hulakov/NosVolt/hardware/NosVolt.kicad_pcb

## KiCad design hardware/NosVolt.kicad_pcb (2026-01-12)

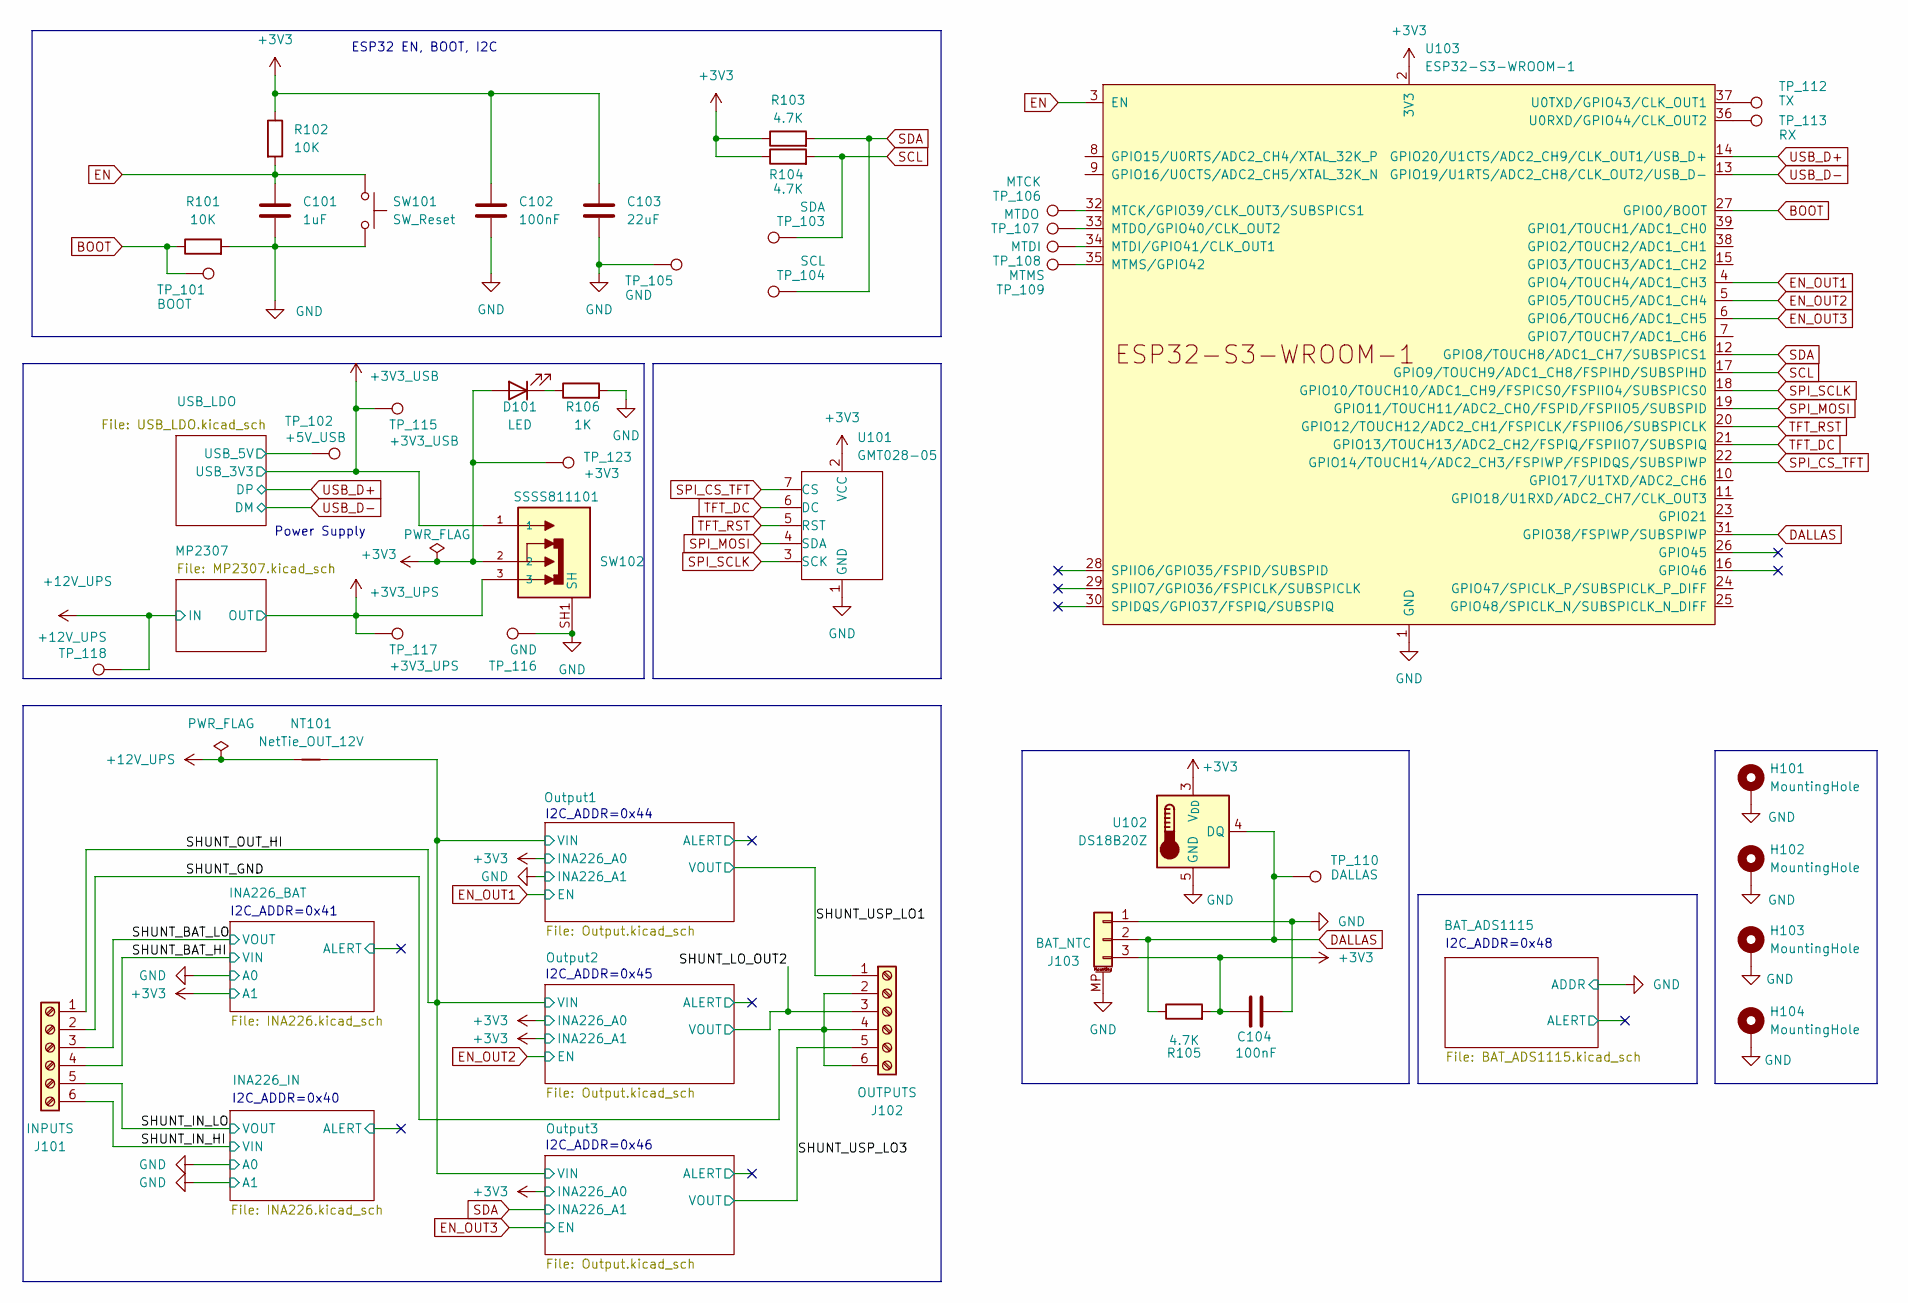
[picture p1: schematic NosVolt.kicad_sch]

Parts:
C101: 1uF; C_0805_2012Metric_Pad1.18x1.45mm_HandSolder
C102, C104: 100nF; C_0603_1608Metric_Pad1.08x0.95mm_HandSolder
C103: 22uF; C_0805_2012Metric_Pad1.18x1.45mm_HandSolder
D101: LED; LED_0805_2012Metric_Pad1.15x1.40mm_HandSolder
H101, H102, H103, H104: MountingHole; MountingHole_3.2mm_M3_Pad_Via
J101: INPUTS; TerminalBlock_Phoenix_MKDS-1,5-6-5.08_1x06_P5.08mm_Horizont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
J102: OUTPUTS; TerminalBlock_Phoenix_MKDS-1,5-6-5.08_1x06_P5.08mm_Horizont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
J103: BAT_NTC; JST_GH_SM03B-GHS-TB_1x03-1MP_P1.25mm_Horizontal
NT101: NetTie_OUT_12V; NetTie-2_SMD_Pad0.5mm
R101, R102: 10K; R_0603_1608Metric_Pad0.98x0.95mm_HandSolder
R103, R104, R105: 4.7K; R_0603_1608Metric_Pad0.98x0.95mm_HandSolder
R106: 1K; R_0603_1608Metric_Pad0.98x0.95mm_HandSolder
SW101: SW_Reset; SW_Push_SPST_NO_Alps_SKRK
SW102: SSSS811101; SW_SSSS811101
TP_101: BOOT; TestPoint_Pad_1.0x1.0mm
TP_102: +5V_USB; TestPoint_Pad_1.0x1.0mm
TP_103: SDA; TestPoint_Pad_1.0x1.0mm
TP_104: SCL; TestPoint_Pad_1.0x1.0mm
TP_105, TP_116: GND; TestPoint_Pad_1.0x1.0mm
TP_106: MTCK; TestPoint_Pad_1.0x1.0mm
TP_107: MTDO; TestPoint_Pad_1.0x1.0mm
TP_108: MTDI; TestPoint_Pad_1.0x1.0mm
TP_109: MTMS; TestPoint_Pad_1.0x1.0mm
TP_110: DALLAS; TestPoint_Pad_1.0x1.0mm
TP_112: TX; TestPoint_Pad_1.0x1.0mm
TP_113: RX; TestPoint_Pad_1.0x1.0mm
TP_115: +3V3_USB; TestPoint_Pad_1.0x1.0mm
TP_117: +3V3_UPS; TestPoint_Pad_1.0x1.0mm
TP_118: +12V_UPS; TestPoint_Pad_1.0x1.0mm
TP_123: +3V3; TestPoint_Pad_1.0x1.0mm
U101: GMT028-05
U102: DS18B20Z; SOIC-8_3.9x4.9mm_P1.27mm
U103: ESP32-S3-WROOM-1

Connections:
+3V3: C102.1, C103.1, C104.1, D101.2 (A), J103.3, R102.1, R103.1, R104.1, R105.2, SW102.2, TP_123.1, U101.2 (VCC), U102.3 (V_{DD}), U103.2 (3V3); also elsewhere on the board
+3V3_UPS: SW102.3, TP_117.1; also elsewhere on the board
+3V3_USB: SW102.1, TP_115.1; also elsewhere on the board
+12V_UPS: NT101.1, TP_118.1; also elsewhere on the board
/SHUNT_BAT_HI: J101.4; also elsewhere on the board
/SHUNT_BAT_LO: J101.3; also elsewhere on the board
/SHUNT_GND: J101.2, J102.2, J102.4, J102.6
/SHUNT_IN_HI: J101.6; also elsewhere on the board
/SHUNT_IN_LO: J101.5; also elsewhere on the board
/SHUNT_LO_OUT2: J102.3; also elsewhere on the board
/SHUNT_OUT_HI: J101.1, NT101.2; also elsewhere on the board
/SHUNT_USP_LO1: J102.1; also elsewhere on the board
/SHUNT_USP_LO3: J102.5; also elsewhere on the board
/USB_LDO/USB_5V: TP_102.1; also elsewhere on the board
BOOT: R101.1, TP_101.1, U103.27 (GPIO0/BOOT)
DALLAS: J103.2, R105.1, TP_110.1, U102.4 (DQ), U103.31 (GPIO38/FSPIWP/SUBSPIWP)
EN: C101.1, R102.2, SW101.1, U103.3 (EN)
EN_OUT1: U103.4 (GPIO4/TOUCH4/ADC1_CH3); also elsewhere on the board
EN_OUT2: U103.5 (GPIO5/TOUCH5/ADC1_CH4); also elsewhere on the board
EN_OUT3: U103.6 (GPIO6/TOUCH6/ADC1_CH5); also elsewhere on the board
GND: C101.2, C102.2, C103.2, C104.2, H101.1, H102.1, H103.1, H104.1, J103.1, J103.MP (MountPin), R101.2, R106.2, SW101.2, SW102.SH1 (SH), SW102.SH2 (SH), SW102.SH3 (SH), SW102.SH4 (SH), TP_105.1, TP_116.1, U101.1 (GND), U102.5 (GND), U103.1 (GND), U103.40 (GND), U103.41 (GND); also elsewhere on the board
unnamed: D101.1 (K), R106.1
unnamed: TP_106.1, U103.32 (MTCK/GPIO39/CLK_OUT3/SUBSPICS1)
unnamed: TP_108.1, U103.34 (MTDI/GPIO41/CLK_OUT1)
unnamed: TP_107.1, U103.33 (MTDO/GPIO40/CLK_OUT2)
unnamed: TP_109.1, U103.35 (MTMS/GPIO42)
unnamed: TP_113.1, U103.36 (U0RXD/GPIO44/CLK_OUT2)
unnamed: TP_112.1, U103.37 (U0TXD/GPIO43/CLK_OUT1)
SCL: R104.2, TP_103.1, U103.17 (GPIO9/TOUCH9/ADC1_CH8/FSPIHD/SUBSPIHD); also elsewhere on the board
SDA: R103.2, TP_104.1, U103.12 (GPIO8/TOUCH8/ADC1_CH7/SUBSPICS1); also elsewhere on the board
SPI_CS_TFT: U101.7 (CS), U103.22 (GPIO14/TOUCH14/ADC2_CH3/FSPIWP/FSPIDQS/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)
SPI_MOSI: U101.4 (SDA), U103.19 (GPIO11/TOUCH11/ADC2_CH0/FSPID/FSPIIO5/S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)
SPI_SCLK: U101.3 (SCK), U103.18 (GPIO10/TOUCH10/ADC1_CH9/FSPICS0/FSPIIO4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)
TFT_DC: U101.6 (DC), U103.21 (GPIO13/TOUCH13/ADC2_CH2/FSPIQ/FSPIIO7/S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)
TFT_RST: U101.5 (RST), U103.20 (GPIO12/TOUCH12/ADC2_CH1/FSPICLK/FSPIIO6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)
USB_D+: U103.14 (GPIO20/U1CTS/ADC2_CH9/CLK_OUT1/USB_D+); also elsewhere on the board
USB_D-: U103.13 (GPIO19/U1RTS/ADC2_CH8/CLK_OUT2/USB_D-); also elsewhere on the board

Notes on the sheet:
Power Supply
I2C_ADDR=0x46
I2C_ADDR=0x41
ESP32 EN, BOOT, I2C
I2C_ADDR=0x48
I2C_ADDR=0x45
I2C_ADDR=0x40
I2C_ADDR=0x44

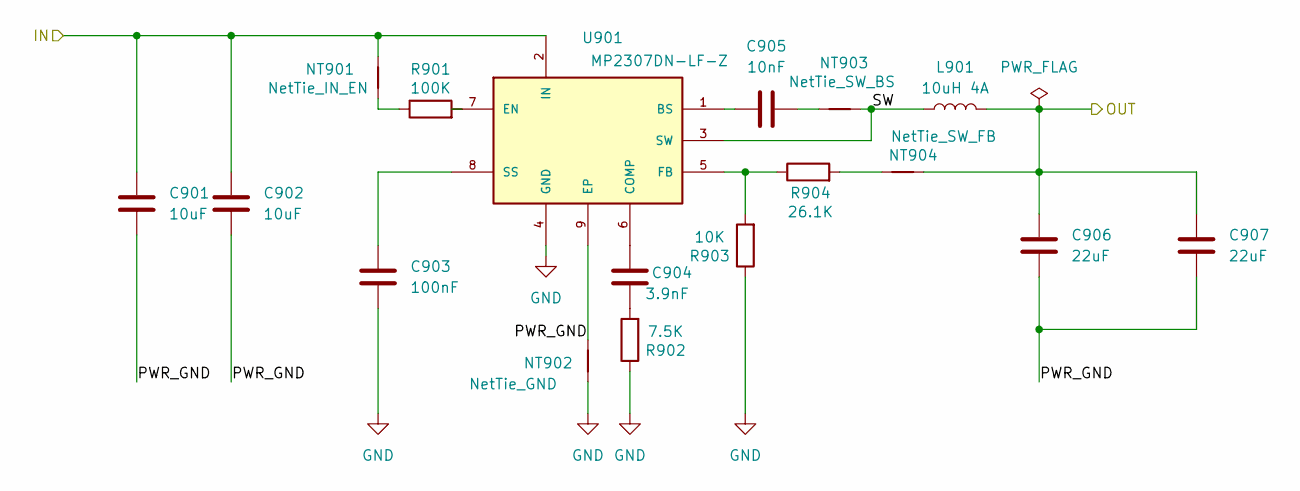
[picture p2: schematic MP2307.kicad_sch]

Parts:
C901, C902: 10uF; C_0805_2012Metric_Pad1.18x1.45mm_HandSolder
C903: 100nF; C_0603_1608Metric_Pad1.08x0.95mm_HandSolder
C904: 3.9nF; C_0805_2012Metric_Pad1.18x1.45mm_HandSolder
C905: 10nF; C_0603_1608Metric_Pad1.08x0.95mm_HandSolder
C906, C907: 22uF; C_0805_2012Metric_Pad1.18x1.45mm_HandSolder
L901: 10uH 4A; L_6.3x6.3_H3
NT901: NetTie_IN_EN; NetTie-2_SMD_Pad0.5mm
NT902: NetTie_GND; NetTie-2_SMD_Pad0.5mm
NT903: NetTie_SW_BS; NetTie-2_SMD_Pad0.5mm
NT904: NetTie_SW_FB; NetTie-2_SMD_Pad0.5mm
R901: 100K; R_0603_1608Metric_Pad0.98x0.95mm_HandSolder
R902: 7.5K; R_0603_1608Metric_Pad0.98x0.95mm_HandSolder
R903: 10K; R_0603_1608Metric_Pad0.98x0.95mm_HandSolder
R904: 26.1K; R_0603_1608Metric_Pad0.98x0.95mm_HandSolder
U901: MP2307DN-LF-Z; SOIC-8-1EP_3.9x4.9mm_P1.27mm_EP2.29x3mm_ThermalVias

Connections:
+3V3_UPS: C906.1, C907.1, L901.2, NT904.2; also elsewhere on the board
+12V_UPS: C901.1, C902.1, NT901.1, U901.2 (IN); also elsewhere on the board
/MP2307/PWR_GND: C901.2, C902.2, C906.2, C907.2, NT902.2, U901.9 (EP)
/MP2307/SW: L901.1, NT903.2, U901.3 (SW)
GND: C903.2, NT902.1, R902.1, R903.1, U901.4 (GND); also elsewhere on the board
unnamed: C904.2, R902.2
unnamed: C905.2, NT903.1
unnamed: NT901.2, R901.1
unnamed: NT904.1, R904.2
unnamed: C905.1, U901.1 (BS)
unnamed: C904.1, U901.6 (COMP)
unnamed: R901.2, U901.7 (EN)
unnamed: R903.2, R904.1, U901.5 (FB)
unnamed: C903.1, U901.8 (SS)

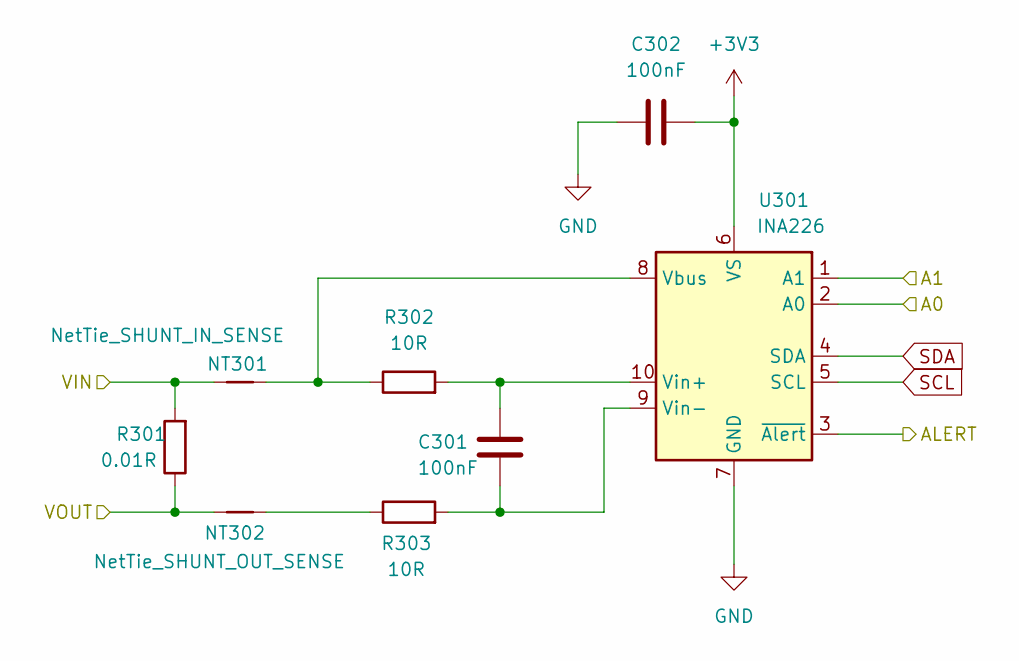
[picture p3: schematic INA226.kicad_sch]

Parts:
C301, C302: 100nF; C_0603_1608Metric_Pad1.08x0.95mm_HandSolder
NT301: NetTie_SHUNT_IN_SENSE; NetTie-2_SMD_Pad0.5mm
NT302: NetTie_SHUNT_OUT_SENSE; NetTie-2_SMD_Pad0.5mm
R301: 0.01R; R_2512_6332Metric_Pad1.40x3.35mm_HandSolder
R302, R303: 10R; R_0603_1608Metric_Pad0.98x0.95mm_HandSolder
U301: INA226; VSSOP-10_3x3mm_P0.5mm

Connections:
+3V3: C302.1, U301.6 (VS); also elsewhere on the board
/INA226_IN/ALERT: U301.3 (~Alert)
/SHUNT_IN_HI: NT301.1, R301.2; also elsewhere on the board
/SHUNT_IN_LO: NT302.1, R301.1; also elsewhere on the board
GND: C302.2, U301.1 (A1), U301.2 (A0), U301.7 (GND); also elsewhere on the board
unnamed: NT302.2, R303.1
unnamed: NT301.2, R302.1, U301.8 (Vbus)
unnamed: C301.1, R302.2, U301.10 (Vin+)
unnamed: C301.2, R303.2, U301.9 (Vin-)
SCL: U301.5 (SCL); also elsewhere on the board
SDA: U301.4 (SDA); also elsewhere on the board

Parts of its further copies:
C401, C402, C502, C504, C602, C604, C702, C704: 100nF; C_0603_1608Metric_Pad1.08x0.95mm_HandSolder
NT401, NT502, NT602, NT702: NetTie_SHUNT_IN_SENSE; NetTie-2_SMD_Pad0.5mm
NT402, NT503, NT603, NT703: NetTie_SHUNT_OUT_SENSE; NetTie-2_SMD_Pad0.5mm
R401, R504, R604, R704: 0.01R; R_2512_6332Metric_Pad1.40x3.35mm_HandSolder
R402, R403, R506, R507, R606, R607, R706, R707: 10R; R_0603_1608Metric_Pad0.98x0.95mm_HandSolder
U401, U501, U601, U701: INA226; VSSOP-10_3x3mm_P0.5mm

Connections of its further copies:
+3V3: C402.1, C504.1, C604.1, C704.1, U401.1 (A1), U401.6 (VS), U501.2 (A0), U501.6 (VS), U601.1 (A1), U601.2 (A0), U601.6 (VS), U701.2 (A0), U701.6 (VS); also elsewhere on the board
/INA226_BAT/ALERT: U401.3 (~Alert)
/Output1/ALERT: U701.3 (~Alert)
/Output1/SHUNT_DRAIN: NT702.1, R704.2; also elsewhere on the board
/Output2/ALERT: U601.3 (~Alert)
/Output2/SHUNT_DRAIN: NT602.1, R604.2; also elsewhere on the board
/Output3/ALERT: U501.3 (~Alert)
/Output3/SHUNT_DRAIN: NT502.1, R504.2; also elsewhere on the board
/SHUNT_BAT_HI: NT401.1, R401.2; also elsewhere on the board
/SHUNT_BAT_LO: NT402.1, R401.1; also elsewhere on the board
/SHUNT_LO_OUT2: NT603.1, R604.1; also elsewhere on the board
/SHUNT_USP_LO1: NT703.1, R704.1; also elsewhere on the board
/SHUNT_USP_LO3: NT503.1, R504.1; also elsewhere on the board
GND: C402.2, C504.2, C604.2, C704.2, U401.2 (A0), U401.7 (GND), U501.7 (GND), U601.7 (GND), U701.1 (A1), U701.7 (GND); also elsewhere on the board
unnamed: NT402.2, R403.1
unnamed: NT503.2, R507.1
unnamed: NT603.2, R607.1
unnamed: NT703.2, R707.1
unnamed: NT401.2, R402.1, U401.8 (Vbus)
unnamed: C401.1, R402.2, U401.10 (Vin+)
unnamed: C401.2, R403.2, U401.9 (Vin-)
unnamed: NT502.2, R506.1, U501.8 (Vbus)
unnamed: C502.1, R506.2, U501.10 (Vin+)
unnamed: C502.2, R507.2, U501.9 (Vin-)
unnamed: NT602.2, R606.1, U601.8 (Vbus)
unnamed: C602.1, R606.2, U601.10 (Vin+)
unnamed: C602.2, R607.2, U601.9 (Vin-)
unnamed: NT702.2, R706.1, U701.8 (Vbus)
unnamed: C702.1, R706.2, U701.10 (Vin+)
unnamed: C702.2, R707.2, U701.9 (Vin-)
SCL: U401.5 (SCL), U501.5 (SCL), U601.5 (SCL), U701.5 (SCL); also elsewhere on the board
SDA: U401.4 (SDA), U501.1 (A1), U501.4 (SDA), U601.4 (SDA), U701.4 (SDA); also elsewhere on the board

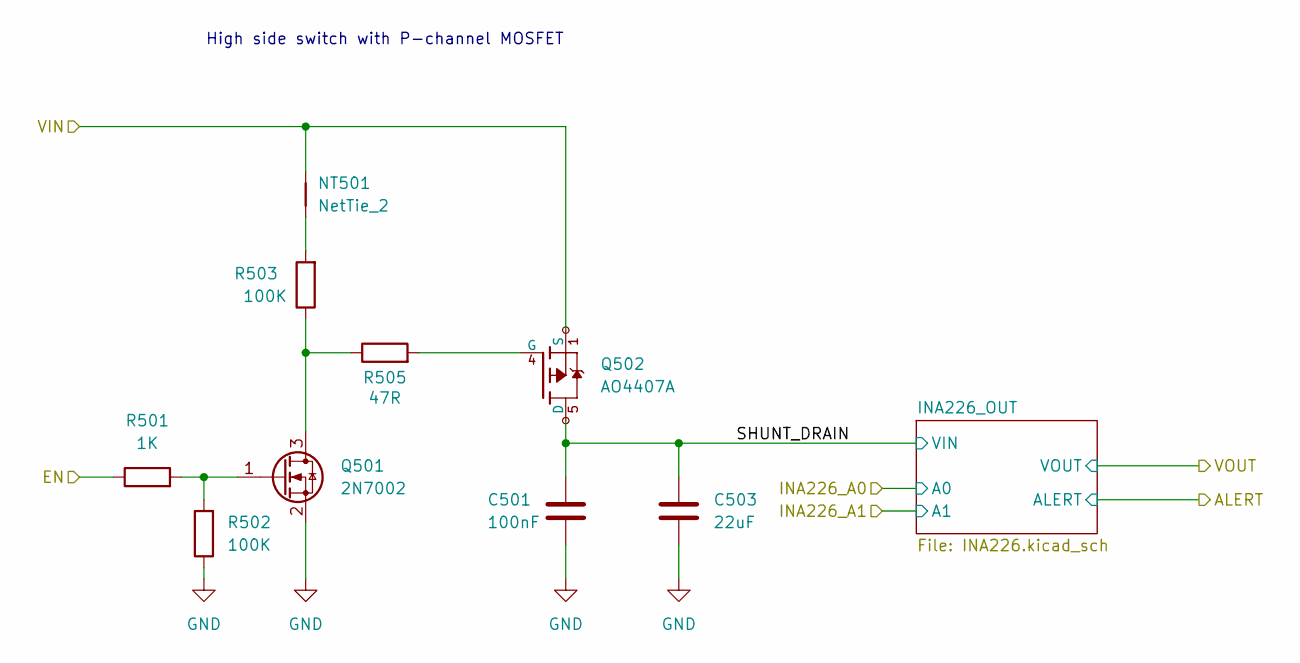
[picture p4: schematic Output.kicad_sch]

Parts:
C501: 100nF; C_0603_1608Metric_Pad1.08x0.95mm_HandSolder
C503: 22uF; C_0805_2012Metric_Pad1.18x1.45mm_HandSolder
NT501: NetTie_2; NetTie-2_SMD_Pad0.5mm
Q501: 2N7002; SOT-23
Q502: AO4407A; SOIC-8_3.9x4.9mm_P1.27mm
R501: 1K; R_0603_1608Metric_Pad0.98x0.95mm_HandSolder
R502, R503: 100K; R_0603_1608Metric_Pad0.98x0.95mm_HandSolder
R505: 47R; R_0603_1608Metric_Pad0.98x0.95mm_HandSolder

Connections:
/Output3/SHUNT_DRAIN: C501.1, C503.1, Q502.5 (D), Q502.6 (D), Q502.7 (D), Q502.8 (D); also elsewhere on the board
/SHUNT_OUT_HI: NT501.2, Q502.1 (S), Q502.2 (S), Q502.3 (S); also elsewhere on the board
EN_OUT3: R501.1; also elsewhere on the board
GND: C501.2, C503.2, Q501.2 (S), R502.1; also elsewhere on the board
unnamed: NT501.1, R503.2
unnamed: Q501.3 (D), R503.1, R505.1
unnamed: Q501.1 (G), R501.2, R502.2
unnamed: Q502.4 (G), R505.2

Parts of its further copies:
C601, C701: 100nF; C_0603_1608Metric_Pad1.08x0.95mm_HandSolder
C603, C703: 22uF; C_0805_2012Metric_Pad1.18x1.45mm_HandSolder
NT601, NT701: NetTie_2; NetTie-2_SMD_Pad0.5mm
Q601, Q701: 2N7002; SOT-23
Q602, Q702: AO4407A; SOIC-8_3.9x4.9mm_P1.27mm
R601, R701: 1K; R_0603_1608Metric_Pad0.98x0.95mm_HandSolder
R602, R603, R702, R703: 100K; R_0603_1608Metric_Pad0.98x0.95mm_HandSolder
R605, R705: 47R; R_0603_1608Metric_Pad0.98x0.95mm_HandSolder

Connections of its further copies:
/Output1/SHUNT_DRAIN: C701.1, C703.1, Q702.5 (D), Q702.6 (D), Q702.7 (D), Q702.8 (D); also elsewhere on the board
/Output2/SHUNT_DRAIN: C601.1, C603.1, Q602.5 (D), Q602.6 (D), Q602.7 (D), Q602.8 (D); also elsewhere on the board
/SHUNT_OUT_HI: NT601.2, NT701.2, Q602.1 (S), Q602.2 (S), Q602.3 (S), Q702.1 (S), Q702.2 (S), Q702.3 (S); also elsewhere on the board
EN_OUT1: R701.1; also elsewhere on the board
EN_OUT2: R601.1; also elsewhere on the board
GND: C601.2, C603.2, C701.2, C703.2, Q601.2 (S), Q701.2 (S), R602.1, R702.1; also elsewhere on the board
unnamed: NT601.1, R603.2
unnamed: NT701.1, R703.2
unnamed: Q601.3 (D), R603.1, R605.1
unnamed: Q601.1 (G), R601.2, R602.2
unnamed: Q602.4 (G), R605.2
unnamed: Q701.3 (D), R703.1, R705.1
unnamed: Q701.1 (G), R701.2, R702.2
unnamed: Q702.4 (G), R705.2

Notes on the sheet:
High side switch with P-channel MOSFET

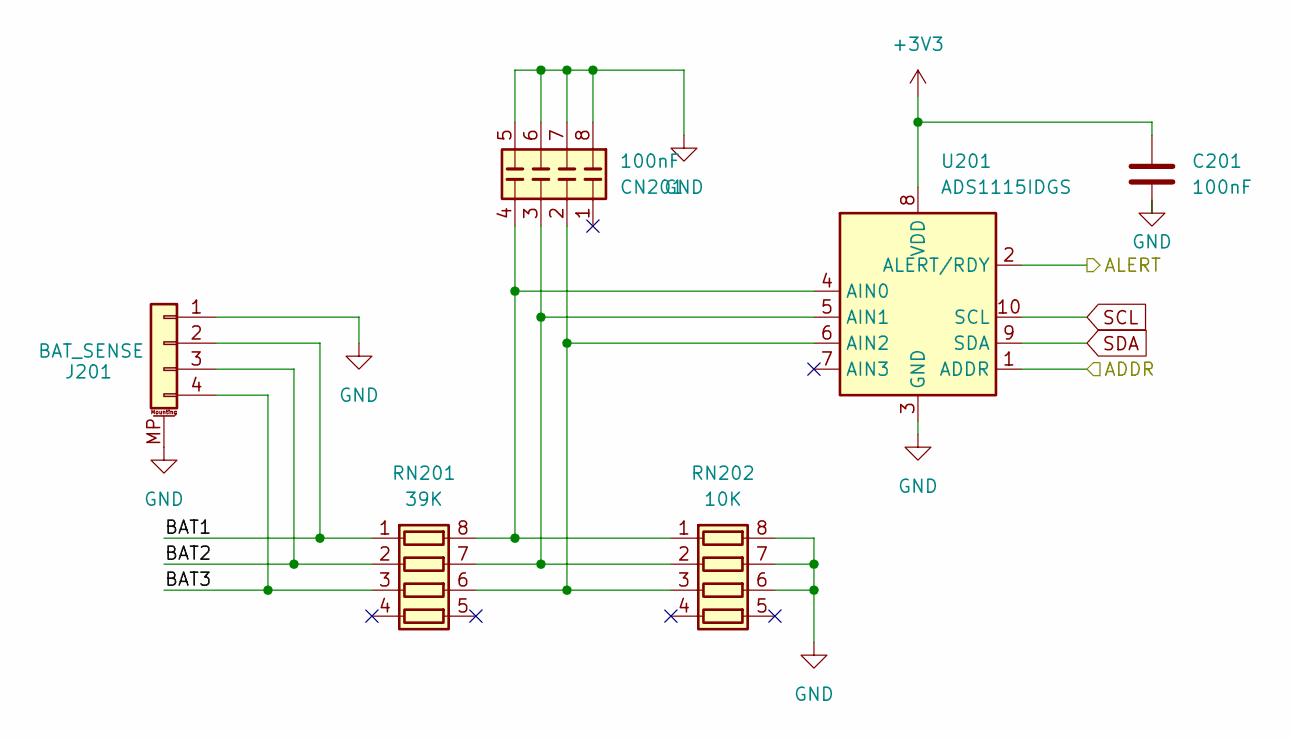
[picture p5: schematic BAT_ADS1115.kicad_sch]

Parts:
C201: 100nF; C_0603_1608Metric_Pad1.08x0.95mm_HandSolder
CN201: 100nF; C_Array_Convex_4x0603
J201: BAT_SENSE; JST_GH_SM04B-GHS-TB_1x04-1MP_P1.25mm_Horizontal
RN201: 39K; R_Array_Convex_4x0603
RN202: 10K; R_Array_Convex_4x0603
U201: ADS1115IDGS; TSSOP-10_3x3mm_P0.5mm

Connections:
+3V3: C201.1, U201.8 (VDD); also elsewhere on the board
/BAT_ADS1115/ALERT: U201.2 (ALERT/RDY)
BAT_1: J201.2, RN201.1 (R1.1)
BAT_2: J201.3, RN201.2 (R2.1)
BAT_3: J201.4, RN201.3 (R3.1)
GND: C201.2, CN201.5 (C4.1), CN201.6 (C3.1), CN201.7 (C2.1), CN201.8 (C1.1), J201.1, J201.MP (MountPin), RN202.6 (R3.2), RN202.7 (R2.2), RN202.8 (R1.2), U201.1 (ADDR), U201.3 (GND); also elsewhere on the board
unnamed: CN201.4 (C4.1), RN201.8 (R1.2), RN202.1 (R1.1), U201.4 (AIN0)
unnamed: CN201.3 (C3.1), RN201.7 (R2.2), RN202.2 (R2.1), U201.5 (AIN1)
unnamed: CN201.2 (C2.1), RN201.6 (R3.2), RN202.3 (R3.1), U201.6 (AIN2)
SCL: U201.10 (SCL); also elsewhere on the board
SDA: U201.9 (SDA); also elsewhere on the board

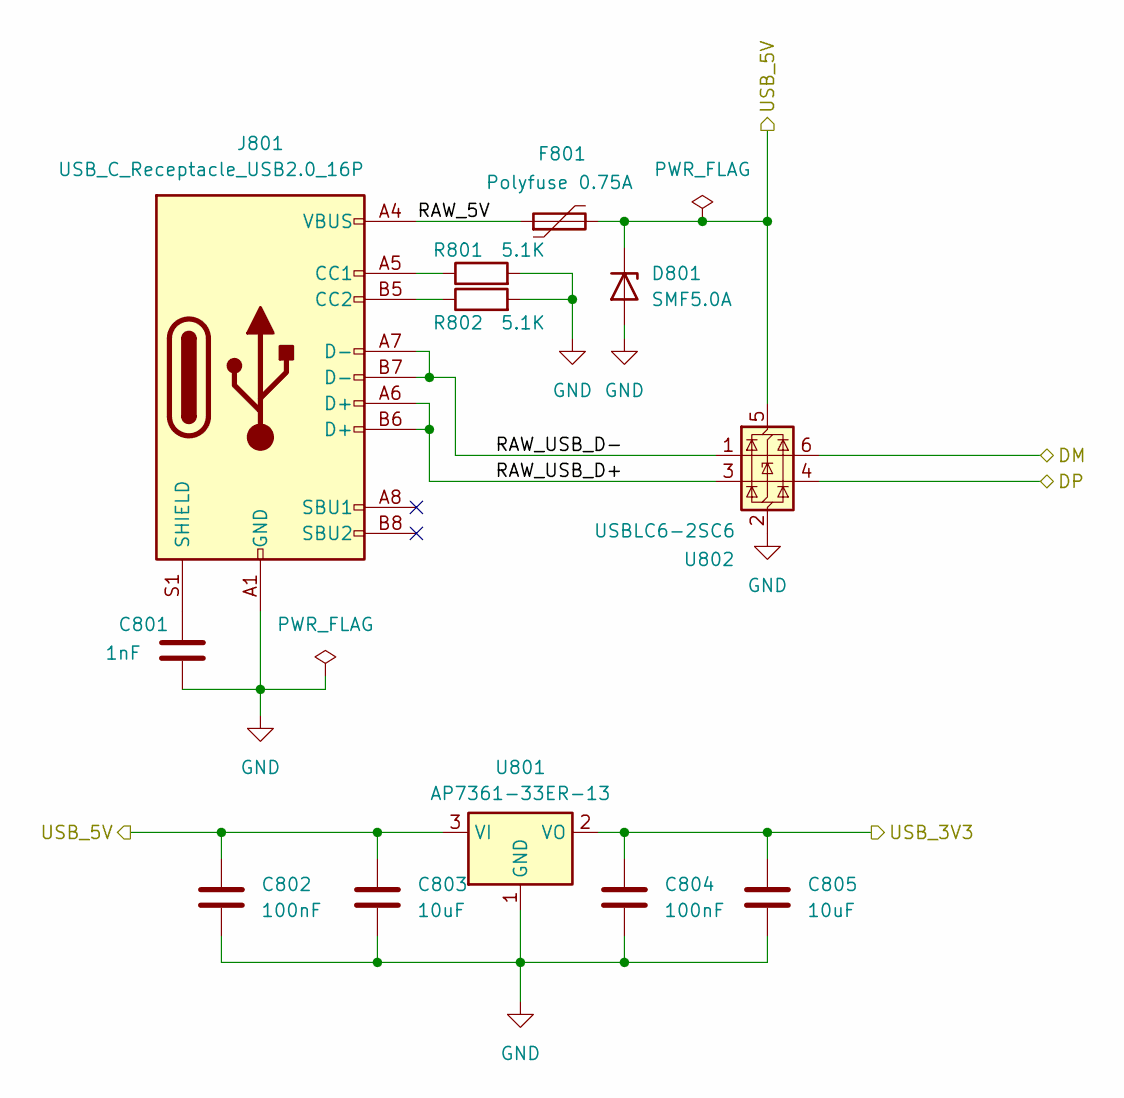
[picture p6: schematic USB_LDO.kicad_sch]

Parts:
C801: 1nF; C_0805_2012Metric_Pad1.18x1.45mm_HandSolder
C802, C804: 100nF; C_0603_1608Metric_Pad1.08x0.95mm_HandSolder
C803, C805: 10uF; C_0805_2012Metric_Pad1.18x1.45mm_HandSolder
D801: SMF5.0A; D_SMF
F801: Polyfuse 0.75A; Fuse_0805_2012Metric
J801: USB_C_Receptacle_USB2.0_16P; USB_C_Receptacle_HRO_TYPE-C-31-M-12
R801, R802: 5.1K; R_0603_1608Metric_Pad0.98x0.95mm_HandSolder
U801: AP7361-33ER-13; SOT-223-3_TabPin2
U802: USBLC6-2SC6; SOT-23-6

Connections:
+3V3_USB: C804.1, C805.1, U801.2 (VO); also elsewhere on the board
/USB_LDO/RAW_5V: F801.1, J801.A4 (VBUS), J801.A9 (VBUS), J801.B4 (VBUS), J801.B9 (VBUS)
/USB_LDO/RAW_USB_D+: J801.A6 (D+), J801.B6 (D+), U802.3 (I/O2)
/USB_LDO/RAW_USB_D-: J801.A7 (D-), J801.B7 (D-), U802.1 (I/O1)
/USB_LDO/USB_5V: C802.1, C803.1, D801.1 (K), F801.2, U801.3 (VI), U802.5 (VBUS); also elsewhere on the board
GND: C801.2, C802.2, C803.2, C804.2, C805.2, D801.2 (A), J801.A1 (GND), J801.A12 (GND), J801.B1 (GND), J801.B12 (GND), R801.2, R802.2, U801.1 (GND), U802.2 (GND); also elsewhere on the board
unnamed: J801.A5 (CC1), R801.1
unnamed: J801.B5 (CC2), R802.1
unnamed: C801.1, J801.S1 (SHIELD)
USB_D+: U802.4 (I/O2); also elsewhere on the board
USB_D-: U802.6 (I/O1); also elsewhere on the board

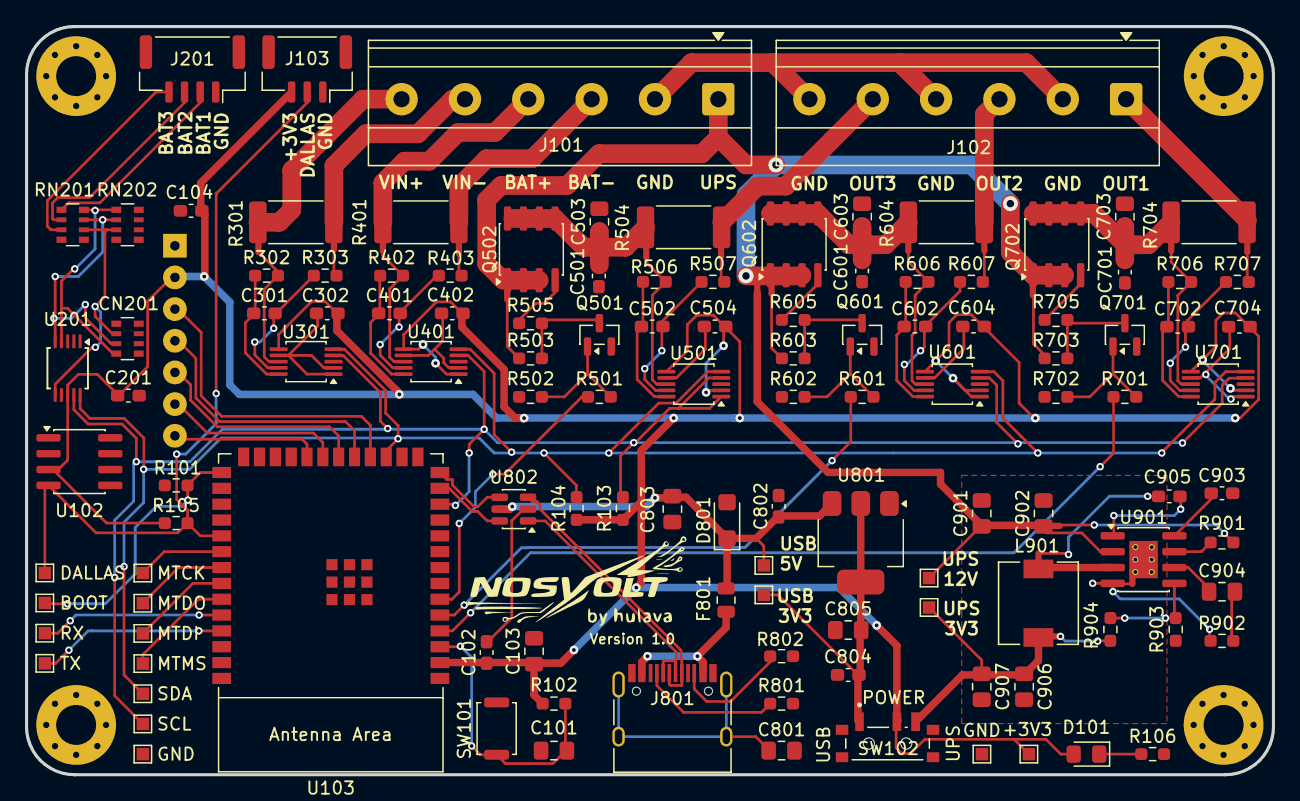
[picture p7: board NosVolt.kicad_pcb from above]

Board: 2 copper layers, 100.0 x 60.0 mm, 143 parts (1 on the bottom side), 95 nets.
