hulakov/NosVolt/(commit log)

2026-01-01 Outputs and current measurement
    [INA226.kicad_sch, MP2307.kicad_sch, Meters.kicad_sch, NosVolt.kicad_pcb, NosVolt.kicad_sch, Output.kicad_sch, USB_LDO.kicad_sch]
2026-01-02 Tracing 1
    [NosVolt.kicad_pcb, NosVolt.kicad_sch, USB_LDO.kicad_sch]
2026-01-03 Tracing 2
    [INA226.kicad_sch, NosVolt.kicad_pcb, NosVolt.kicad_sch, Output.kicad_sch]
2026-01-04 Tracing 3
    [BAT_ADS1115.kicad_sch, INA226.kicad_sch, Meters.kicad_sch, NosVolt.kicad_pcb, Output.kicad_sch]
2026-01-04 trace ads1115
    [BAT_ADS1115.kicad_sch, NosVolt.kicad_pcb, NosVolt.kicad_sch]
2026-01-05 ldo optimization
    [BAT_ADS1115.kicad_sch, MP2307.kicad_sch, NosVolt.kicad_pcb, NosVolt.kicad_sch]
2026-01-05 Add screen
    [MP2307.kicad_sch, NosVolt.kicad_pcb, NosVolt.kicad_sch, USB_LDO.kicad_sch]
2026-01-07 esp32 c3 mini
    [MP2307.kicad_sch, NosVolt.kicad_pcb, NosVolt.kicad_sch, USB_LDO.kicad_sch]
2026-01-08 thermal relief
    [BAT_ADS1115.kicad_sch, INA226.kicad_sch, MP2307.kicad_sch, NosVolt.kicad_pcb, NosVolt.kicad_sch, Output.kicad_sch, USB_LDO.kicad_sch]
2026-01-08 fix errors
    [NosVolt.kicad_pcb]
2026-01-08 fix errors 2
    [NosVolt.kicad_pcb, Output.kicad_sch]
2026-01-08 Add logo
    [NosVolt.kicad_pcb]
2026-01-08 3mm thermal relief
    [MP2307.kicad_sch]
2026-01-10 page numbers
    [NosVolt.kicad_pcb]
2026-01-11 Test points
    [BAT_ADS1115.kicad_sch, NosVolt.kicad_pcb, NosVolt.kicad_sch]
2026-01-12 hand soldering footprints and led
    [BAT_ADS1115.kicad_sch, INA226.kicad_sch, MP2307.kicad_sch, NosVolt.kicad_sch, Output.kicad_sch, USB_LDO.kicad_sch]
2026-01-12 remove fuse
    [NosVolt.kicad_pcb, NosVolt.kicad_sch]
